Ananda-Hilmy/Smart-Rescue-Wristband/README.md

# Smart-Rescue-Wristband
Implementasi Smart Rescue Wristband Berbasis IoT Menggunakan Sensor Detak Jantung, GPS, dan Komunikasi LoRa Pada Sistem Gelang Pelampung
